knobeast/knobeast/TRADEMARK.md

# Trademark policy / Política de marca

**English**

"knobeast" and the knobeast logo (the italic wordmark with the knob-shaped "O", in `marca/`) are trademarks used by DSM Beauty, S.L. for the knobeast product. They are **not** covered by the open-source licences of this repository (GPL-3.0, CERN-OHL-S-2.0, CC BY-SA 4.0).

You are welcome to:
- build, modify, share and sell devices made from this project, as the licences allow;
- say truthfully that your device is "based on knobeast" or "compatible with knobeast";
- use the name to refer to this project, for example in articles, videos or reviews.

Please don't:
- call your own device, kit, firmware or fork "knobeast";
- use the knobeast logo on it or on its packaging;
- present it as made, sold or endorsed by knobeast.

When you make a fork, give it a different name and remove the logo: `logo_on = false` in `caja/knobeast_caja.scad` and `SPLASH_TITLE` in `pico/config.py`.

Questions: contact@knobeast.com

**Español**

«knobeast» y su logo (el nombre en cursiva con la «O» de pomo, en `marca/`) son marcas que DSM Beauty, S.L. usa para el producto knobeast. **No** están incluidas en las licencias abiertas de este repositorio.

Puedes:
- fabricar, modificar, compartir y vender aparatos basados en el proyecto, según sus licencias;
- decir con verdad que están «basados en knobeast».

No puedes:
- llamar «knobeast» a tu aparato, kit o versión;
- usar el logo;
- dar a entender que lo hace o lo respalda knobeast.

En una versión propia, ponle otro nombre y quita el logo: `logo_on = false` en el `.scad` y `SPLASH_TITLE` en `config.py`.

Dudas: contact@knobeast.com
