knobeast/knobeast/docs/img/render_hero.jpg

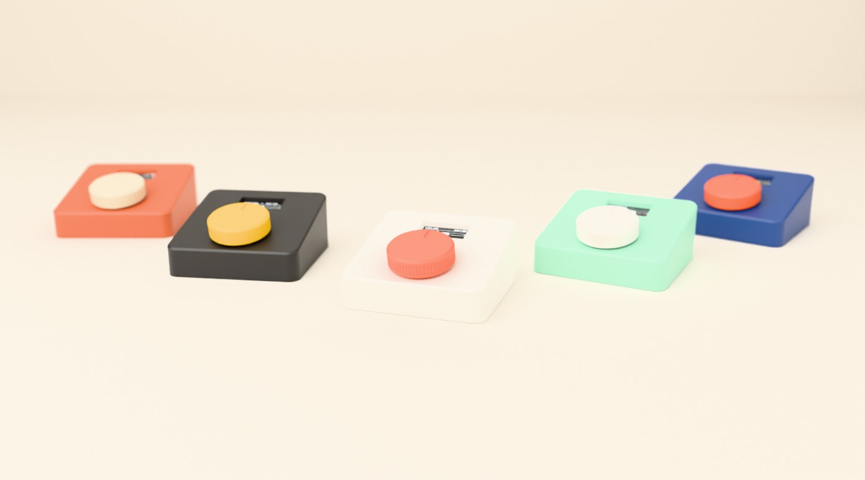
docs/img/render_hero.jpg
