knobeast/knobeast/docs/img/render_pared_lado.jpg

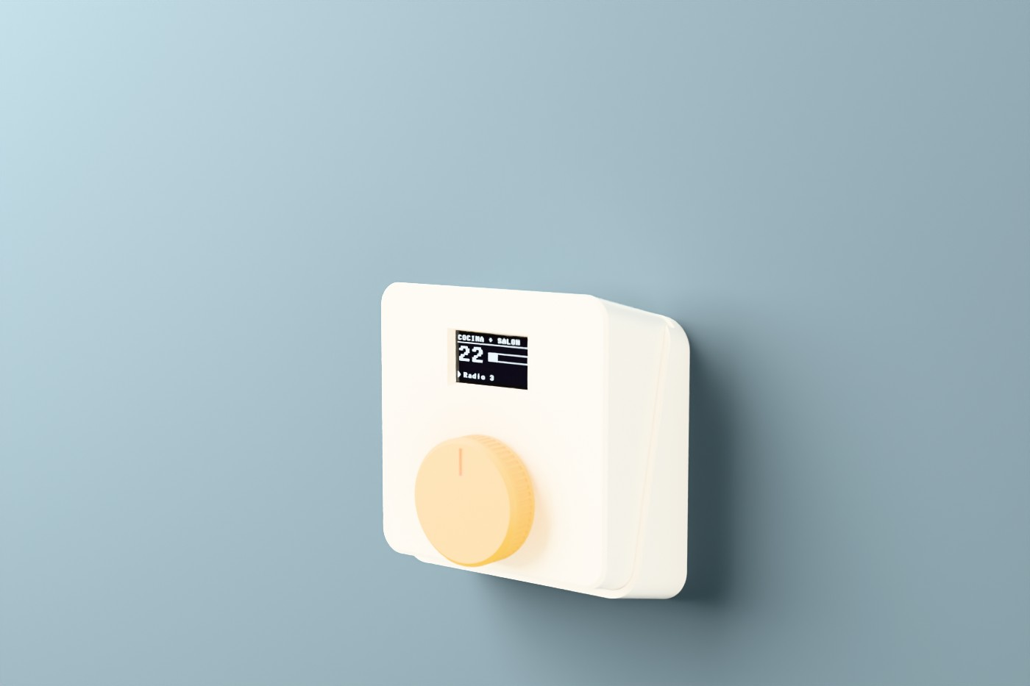
docs/img/render_pared_lado.jpg
