knobeast/knobeast/docs/img/social-preview.jpg

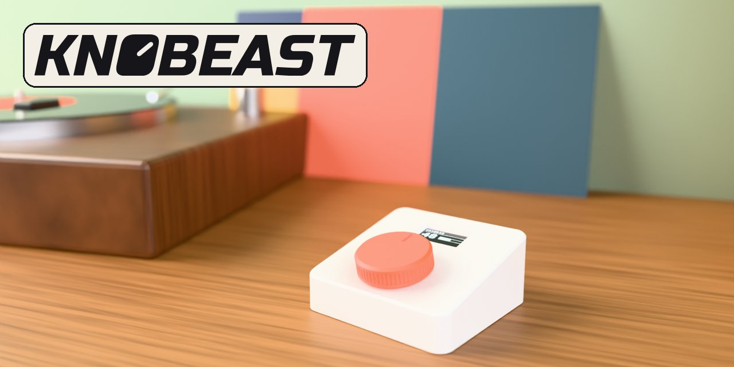
docs/img/social-preview.jpg
