knobeast/knobeast/marca/marca_negro.png

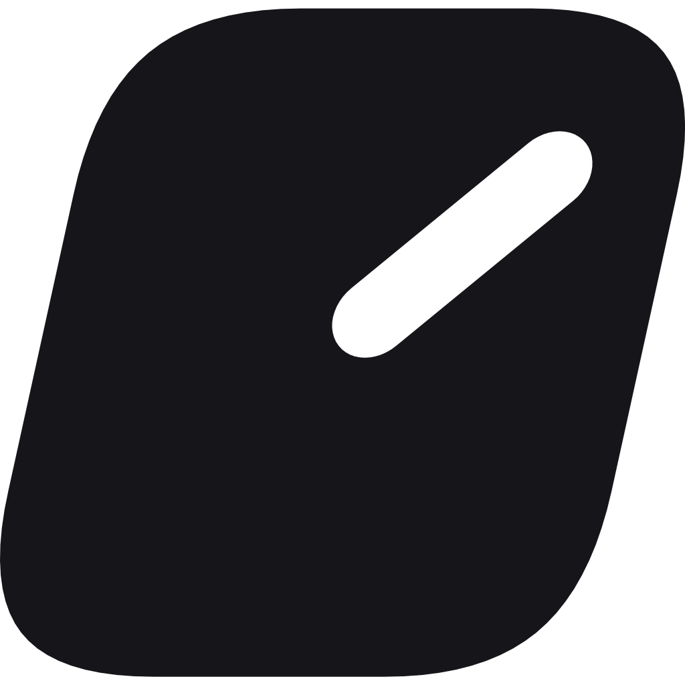
marca/marca_negro.png
