knobeast/knobeast/caja/knobeast_1_carcasa.stl

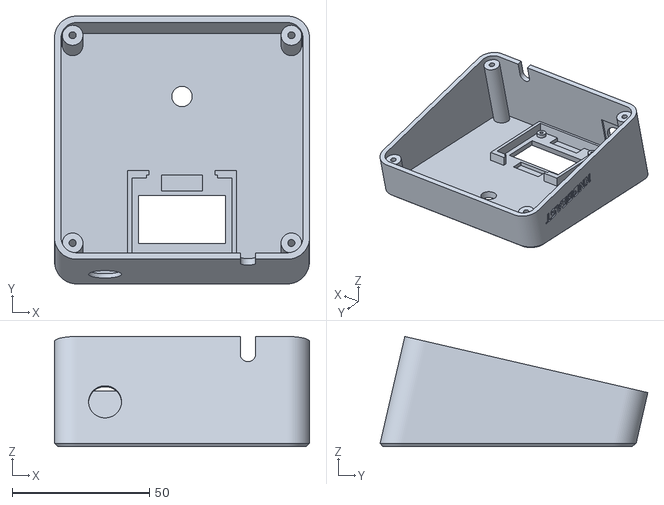
[picture p12: CAD file, 2026-10-18]
caja/knobeast_1_carcasa.stl
92.8 x 97.4 x 40.0
