knobeast/knobeast/caja/knobeast_2_tapa_inferior.stl

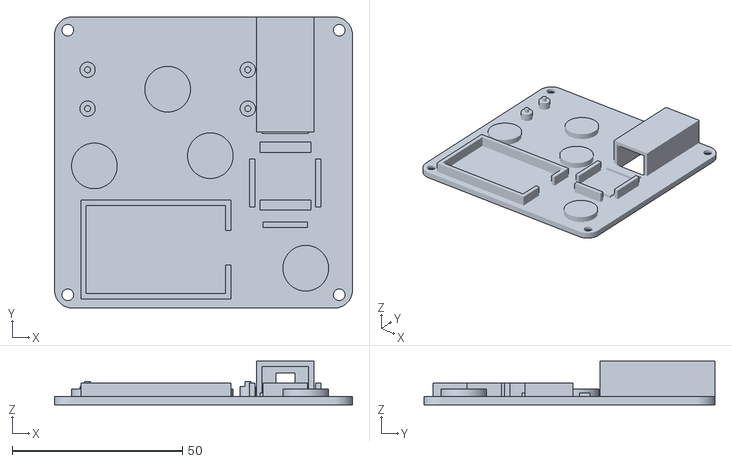
[picture p13: CAD file, 2026-10-17]
caja/knobeast_2_tapa_inferior.stl
87.4 x 85.4 x 12.8
