knobeast/knobeast/caja/knobeast_4_soporte_pared.stl

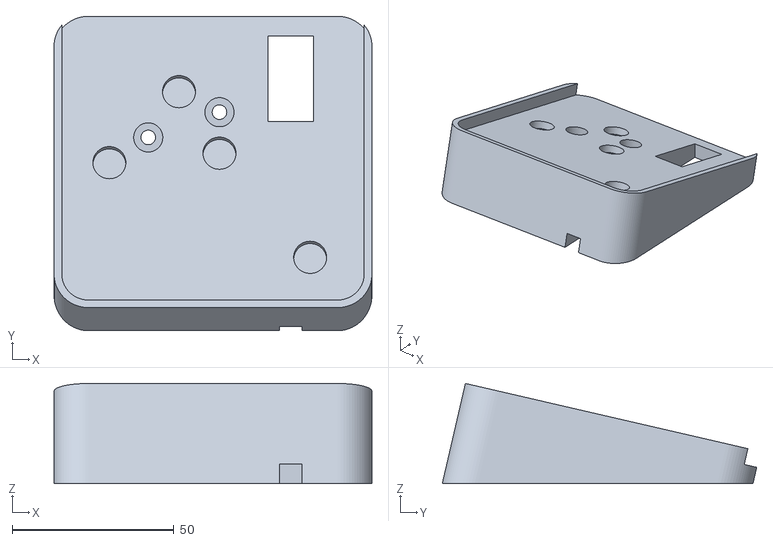
[picture p14: CAD file, 2026-10-17]
caja/knobeast_4_soporte_pared.stl
98.2 x 97.1 x 30.9
