knobeast/knobeast/caja/knobeast_3_pomo.stl

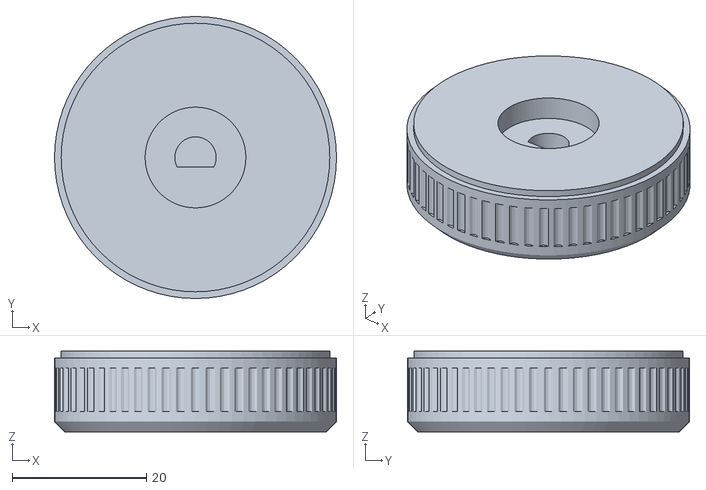
[picture p15: CAD file, 2026-10-17]
caja/knobeast_3_pomo.stl
42.0 x 42.0 x 12.0
