knobeast/knobeast/caja/logo_knobeast.scad

// Logo knobeast (Russo One cursiva, «O» de pomo). Ancho 1 x alto 0.1294: usar scale(ancho).
logo_aspect = 0.12938;
module logo_knobeast_unit() {
    polygon(points=[[0.78898, 0.02613], [0.7959, 0.02583], [0.80219, 0.02559], [0.80786, 0.0254], [0.81291, 0.02527], [0.81733, 0.02518], [0.82113, 0.02516], [0.82195, 0.02518], [0.82274, 0.02525], [0.82351, 0.02538], [0.82425, 0.02555], [0.82497, 0.02576], [0.82567, 0.02603], [0.82634, 0.02635], [0.82699, 0.02671], [0.82762, 0.02712], [0.82822, 0.02758], [0.8288, 0.02809], [0.82933, 0.02862], [0.82982, 0.02919], [0.83026, 0.0298], [0.83067, 0.03044], [0.83104, 0.03111], [0.83136, 0.03182], [0.83165, 0.03256], [0.83189, 0.03333], [0.83209, 0.03414], [0.83565, 0.05031], [0.79432, 0.05031], [0.79067, 0.0504], [0.78726, 0.05066], [0.7841, 0.05108], [0.78118, 0.05168], [0.77851, 0.05245], [0.77608, 0.05339], [0.77389, 0.0545], [0.77195, 0.05578], [0.77025, 0.05723], [0.7688, 0.05885], [0.76757, 0.06066], [0.76657, 0.06268], [0.76577, 0.0649], [0.7652, 0.06733], [0.76484, 0.06997], [0.7647, 0.07281], [0.76477, 0.07586], [0.76506, 0.07912], [0.76557, 0.08258], [0.76629, 0.08625], [0.76748, 0.09164], [0.76837, 0.09531], [0.76939, 0.09878], [0.77053, 0.10204], [0.7718, 0.10509], [0.77319, 0.10793], [0.77471, 0.11057], [0.77636, 0.113], [0.77812, 0.11522], [0.78002, 0.11724], [0.78204, 0.11905], [0.78421, 0.12067], [0.78654, 0.12212], [0.78905, 0.1234], [0.79172, 0.12451], [0.79457, 0.12545], [0.79758, 0.12622], [0.80076, 0.12681], [0.80411, 0.12724], [0.80763, 0.1275], [0.81132, 0.12758], [0.87439, 0.12758], [0.86886, 0.10243], [0.81297, 0.10243], [0.8109, 0.10232], [0.809, 0.10199], [0.80726, 0.10146], [0.80569, 0.1007], [0.80429, 0.09973], [0.80306, 0.09854], [0.802, 0.09714], [0.80111, 0.09553], [0.80038, 0.09369], [0.79982, 0.09164], [0.79903, 0.08805], [0.79869, 0.086], [0.79861, 0.08417], [0.79879, 0.08255], [0.79924, 0.08115], [0.79995, 0.07996], [0.80092, 0.07899], [0.80215, 0.07824], [0.80365, 0.0777], [0.80541, 0.07738], [0.80744, 0.07727], [0.83978, 0.07727], [0.84319, 0.07719], [0.84638, 0.07694], [0.84935, 0.07652], [0.85209, 0.07595], [0.8546, 0.0752], [0.8569, 0.07429], [0.85897, 0.07322], [0.86082, 0.07198], [0.86244, 0.07057], [0.86384, 0.069], [0.86503, 0.06726], [0.86601, 0.06532], [0.86678, 0.0632], [0.86735, 0.06089], [0.86771, 0.0584], [0.86786, 0.05572], [0.86781, 0.05285], [0.86755, 0.0498], [0.86709, 0.04656], [0.86642, 0.04313], [0.86444, 0.03414], [0.8636, 0.03071], [0.86264, 0.02747], [0.86156, 0.02442], [0.86035, 0.02155], [0.85901, 0.01887], [0.85755, 0.01637], [0.85597, 0.01407], [0.85427, 0.01195], [0.85243, 0.01001], [0.85048, 0.00827], [0.84839, 0.0067], [0.84614, 0.00529], [0.84375, 0.00405], [0.84121, 0.00298], [0.83851, 0.00207], [0.83567, 0.00132], [0.83267, 0.00074], [0.82953, 0.00033], [0.82623, 8e-05], [0.82279, 0.0], [0.82094, 0.0], [0.81908, 1e-05], [0.8172, 3e-05], [0.81529, 6e-05], [0.81337, 9e-05], [0.81143, 0.00013], [0.80947, 0.00018], [0.80748, 0.00023], [0.80548, 0.00029], [0.80346, 0.00036], [0.78708, 0.00108], [0.78345, 0.00127], [0.77979, 0.00147], [0.77611, 0.00168], [0.7724, 0.00191], [0.76868, 0.00216], [0.76493, 0.00242], [0.76116, 0.00269], [0.75737, 0.00298], [0.75356, 0.00328], [0.74972, 0.00359], [0.75506, 0.02785], [0.76447, 0.02734], [0.77327, 0.02688], [0.78144, 0.02648]], paths=[[0, 1, 2, 3, 4, 5, 6, 7, 8, 9, 10, 11, 12, 13, 14, 15, 16, 17, 18, 19, 20, 21, 22, 23, 24, 25, 26, 27, 28, 29, 30, 31, 32, 33, 34, 35, 36, 37, 38, 39, 40, 41, 42, 43, 44, 45, 46, 47, 48, 49, 50, 51, 52, 53, 54, 55, 56, 57, 58, 59, 60, 61, 62, 63, 64, 65, 66, 67, 68, 69, 70, 71, 72, 73, 74, 75, 76, 77, 78, 79, 80, 81, 82, 83, 84, 85, 86, 87, 88, 89, 90, 91, 92, 93, 94, 95, 96, 97, 98, 99, 100, 101, 102, 103, 104, 105, 106, 107, 108, 109, 110, 111, 112, 113, 114, 115, 116, 117, 118, 119, 120, 121, 122, 123, 124, 125, 126, 127, 128, 129, 130, 131, 132, 133, 134, 135, 136, 137, 138, 139, 140, 141, 142, 143, 144, 145, 146, 147, 148, 149, 150, 151, 152, 153, 154, 155, 156, 157, 158, 159, 160]]);
    polygon(points=[[0.04915, 0.07817], [0.06532, 0.07817], [0.10422, 0.12758], [0.13836, 0.12758], [0.08951, 0.06559], [0.11051, 0.0018], [0.07637, 0.0018], [0.05978, 0.05301], [0.04361, 0.05301], [0.03235, 0.0018], [0.0, 0.0018], [0.02767, 0.12758], [0.06002, 0.12758]], paths=[[0, 1, 2, 3, 4, 5, 6, 7, 8, 9, 10, 11, 12]]);
    polygon(points=[[0.12147, 0.0018], [0.14915, 0.12758], [0.18329, 0.12758], [0.20981, 0.05211], [0.22642, 0.12758], [0.25876, 0.12758], [0.23109, 0.0018], [0.19695, 0.0018], [0.17042, 0.07727], [0.15382, 0.0018]], paths=[[0, 1, 2, 3, 4, 5, 6, 7, 8, 9]]);
    polygon(points=[[0.36765, 0.01965], [0.36613, 0.01702], [0.36449, 0.01459], [0.36272, 0.01236], [0.36083, 0.01035], [0.35881, 0.00854], [0.35664, 0.00691], [0.3543, 0.00546], [0.3518, 0.00418], [0.34912, 0.00307], [0.34628, 0.00213], [0.34327, 0.00137], [0.34008, 0.00077], [0.33673, 0.00034], [0.33321, 9e-05], [0.32952, 0.0], [0.2846, 0.0], [0.28095, 9e-05], [0.27754, 0.00034], [0.27438, 0.00077], [0.27146, 0.00137], [0.26878, 0.00213], [0.26635, 0.00307], [0.26417, 0.00418], [0.26223, 0.00546], [0.26053, 0.00691], [0.25907, 0.00854], [0.25785, 0.01035], [0.25684, 0.01236], [0.25605, 0.01459], [0.25548, 0.01702], [0.25512, 0.01965], [0.25498, 0.0225], [0.25505, 0.02555], [0.25534, 0.02881], [0.25585, 0.03227], [0.25657, 0.03594], [0.26922, 0.09344], [0.27011, 0.09711], [0.27113, 0.10058], [0.27227, 0.10383], [0.27354, 0.10688], [0.27493, 0.10973], [0.27645, 0.11236], [0.2781, 0.11479], [0.27987, 0.11702], [0.28176, 0.11903], [0.28378, 0.12084], [0.28595, 0.12247], [0.28829, 0.12392], [0.29079, 0.1252], [0.29347, 0.12631], [0.29631, 0.12725], [0.29932, 0.12801], [0.3025, 0.12861], [0.30585, 0.12904], [0.30937, 0.12929], [0.31306, 0.12938], [0.35799, 0.12938], [0.36164, 0.12929], [0.36505, 0.12904], [0.36821, 0.12861], [0.37113, 0.12801], [0.3738, 0.12725], [0.37623, 0.12631], [0.37842, 0.1252], [0.38036, 0.12392], [0.38206, 0.12247], [0.38351, 0.12084], [0.38474, 0.11903], [0.38574, 0.11702], [0.38653, 0.11479], [0.38711, 0.11236], [0.38747, 0.10973], [0.38761, 0.10688], [0.38754, 0.10383], [0.38725, 0.10058], [0.38674, 0.09711], [0.38602, 0.09344], [0.37337, 0.03594], [0.37248, 0.03227], [0.37146, 0.02881], [0.37032, 0.02555], [0.36905, 0.0225], [0.32072, 0.07266], [0.32017, 0.07169], [0.31975, 0.07067], [0.31946, 0.06965], [0.3193, 0.06862], [0.31928, 0.0676], [0.31939, 0.06663], [0.31964, 0.0657], [0.32003, 0.06485], [0.32054, 0.06407], [0.32116, 0.06339], [0.3219, 0.06282], [0.32272, 0.06236], [0.32362, 0.06203], [0.32459, 0.06183], [0.3256, 0.06176], [0.32665, 0.06183], [0.3277, 0.06203], [0.32875, 0.06236], [0.32978, 0.06282], [0.33076, 0.06339], [0.33169, 0.06407], [0.36595, 0.09215], [0.3668, 0.09293], [0.36756, 0.09378], [0.36822, 0.09471], [0.36876, 0.09569], [0.36919, 0.0967], [0.36948, 0.09773], [0.36964, 0.09876], [0.36966, 0.09977], [0.36955, 0.10074], [0.36929, 0.10167], [0.36891, 0.10253], [0.3684, 0.1033], [0.36777, 0.10398], [0.36704, 0.10455], [0.36622, 0.10501], [0.36531, 0.10534], [0.36435, 0.10554], [0.36333, 0.10561], [0.36229, 0.10554], [0.36123, 0.10534], [0.36018, 0.10501], [0.35916, 0.10455], [0.35817, 0.10398], [0.35725, 0.1033], [0.32299, 0.07522], [0.32214, 0.07445], [0.32138, 0.07359]], paths=[[0, 1, 2, 3, 4, 5, 6, 7, 8, 9, 10, 11, 12, 13, 14, 15, 16, 17, 18, 19, 20, 21, 22, 23, 24, 25, 26, 27, 28, 29, 30, 31, 32, 33, 34, 35, 36, 37, 38, 39, 40, 41, 42, 43, 44, 45, 46, 47, 48, 49, 50, 51, 52, 53, 54, 55, 56, 57, 58, 59, 60, 61, 62, 63, 64, 65, 66, 67, 68, 69, 70, 71, 72, 73, 74, 75, 76, 77, 78, 79, 80, 81, 82, 83], [84, 85, 86, 87, 88, 89, 90, 91, 92, 93, 94, 95, 96, 97, 98, 99, 100, 101, 102, 103, 104, 105, 106, 107, 108, 109, 110, 111, 112, 113, 114, 115, 116, 117, 118, 119, 120, 121, 122, 123, 124, 125, 126, 127, 128, 129, 130, 131, 132, 133]]);
    polygon(points=[[0.49821, 0.12558], [0.50051, 0.1247], [0.50259, 0.12366], [0.50445, 0.12247], [0.50608, 0.12111], [0.5075, 0.11959], [0.5087, 0.1179], [0.50969, 0.11605], [0.51049, 0.11404], [0.51108, 0.11185], [0.51148, 0.1095], [0.51167, 0.10698], [0.51165, 0.1043], [0.51144, 0.10144], [0.51102, 0.09842], [0.5104, 0.09524], [0.50989, 0.09312], [0.5093, 0.09109], [0.50864, 0.08913], [0.5079, 0.08726], [0.50709, 0.08547], [0.5062, 0.08376], [0.50523, 0.08212], [0.50419, 0.08058], [0.50307, 0.07911], [0.50188, 0.07772], [0.50063, 0.07641], [0.49937, 0.07518], [0.49807, 0.07404], [0.49675, 0.07297], [0.49541, 0.07199], [0.49404, 0.07109], [0.49264, 0.07027], [0.49122, 0.06952], [0.48977, 0.06886], [0.4883, 0.06828], [0.49092, 0.06738], [0.4933, 0.06624], [0.49544, 0.06488], [0.49735, 0.06328], [0.49902, 0.06146], [0.50045, 0.0594], [0.50164, 0.05711], [0.5026, 0.0546], [0.50332, 0.05185], [0.5038, 0.04888], [0.50389, 0.04774], [0.50394, 0.04658], [0.50394, 0.04537], [0.50391, 0.04413], [0.50382, 0.04286], [0.5037, 0.04155], [0.50352, 0.0402], [0.50331, 0.03881], [0.50305, 0.03739], [0.50275, 0.03594], [0.50191, 0.03251], [0.50095, 0.02927], [0.49987, 0.02621], [0.49866, 0.02335], [0.49732, 0.02066], [0.49586, 0.01817], [0.49428, 0.01586], [0.49258, 0.01374], [0.49075, 0.01181], [0.48879, 0.01006], [0.4867, 0.00849], [0.48446, 0.00709], [0.48206, 0.00585], [0.47952, 0.00477], [0.47682, 0.00386], [0.47398, 0.00312], [0.47098, 0.00254], [0.46784, 0.00213], [0.46454, 0.00188], [0.4611, 0.0018], [0.38383, 0.0018], [0.4115, 0.12758], [0.48338, 0.12758], [0.48679, 0.1275], [0.48998, 0.12726], [0.49294, 0.12686], [0.49569, 0.1263], [0.47067, 0.04942], [0.4697, 0.05039], [0.46847, 0.05114], [0.46697, 0.05168], [0.46521, 0.052], [0.46318, 0.05211], [0.42724, 0.05211], [0.42171, 0.02695], [0.45765, 0.02695], [0.45972, 0.02706], [0.46162, 0.02739], [0.46336, 0.02792], [0.46493, 0.02868], [0.46633, 0.02965], [0.46756, 0.03084], [0.46862, 0.03224], [0.46951, 0.03385], [0.47024, 0.03569], [0.4708, 0.03774], [0.47159, 0.04133], [0.47193, 0.04338], [0.47201, 0.04521], [0.47183, 0.04683], [0.47138, 0.04823], [0.47706, 0.09854], [0.47635, 0.09973], [0.47538, 0.1007], [0.47414, 0.10146], [0.47265, 0.10199], [0.47088, 0.10232], [0.46886, 0.10243], [0.43831, 0.10243], [0.43278, 0.07727], [0.46332, 0.07727], [0.4654, 0.07738], [0.4673, 0.0777], [0.46904, 0.07824], [0.4706, 0.07899], [0.472, 0.07996], [0.47323, 0.08115], [0.4743, 0.08255], [0.47519, 0.08417], [0.47592, 0.086], [0.47648, 0.08805], [0.47727, 0.09164], [0.47761, 0.09369], [0.47769, 0.09553], [0.47751, 0.09714]], paths=[[0, 1, 2, 3, 4, 5, 6, 7, 8, 9, 10, 11, 12, 13, 14, 15, 16, 17, 18, 19, 20, 21, 22, 23, 24, 25, 26, 27, 28, 29, 30, 31, 32, 33, 34, 35, 36, 37, 38, 39, 40, 41, 42, 43, 44, 45, 46, 47, 48, 49, 50, 51, 52, 53, 54, 55, 56, 57, 58, 59, 60, 61, 62, 63, 64, 65, 66, 67, 68, 69, 70, 71, 72, 73, 74, 75, 76, 77, 78, 79, 80, 81, 82], [83, 84, 85, 86, 87, 88, 89, 90, 91, 92, 93, 94, 95, 96, 97, 98, 99, 100, 101, 102, 103, 104, 105, 106], [107, 108, 109, 110, 111, 112, 113, 114, 115, 116, 117, 118, 119, 120, 121, 122, 123, 124, 125, 126, 127, 128, 129, 130]]);
    polygon(points=[[0.63328, 0.10243], [0.56589, 0.10243], [0.56056, 0.07817], [0.61357, 0.07817], [0.60803, 0.05301], [0.55502, 0.05301], [0.54929, 0.02695], [0.61668, 0.02695], [0.61114, 0.0018], [0.51141, 0.0018], [0.53908, 0.12758], [0.63881, 0.12758]], paths=[[0, 1, 2, 3, 4, 5, 6, 7, 8, 9, 10, 11]]);
    polygon(points=[[0.70907, 0.0018], [0.70593, 0.02426], [0.66101, 0.02426], [0.64798, 0.0018], [0.61294, 0.0018], [0.68823, 0.12758], [0.72417, 0.12758], [0.74412, 0.0018], [0.70298, 0.04762], [0.6979, 0.08985], [0.67423, 0.04762]], paths=[[0, 1, 2, 3, 4, 5, 6, 7], [8, 9, 10]]);
    polygon(points=[[0.89218, 0.12758], [1.0, 0.12758], [0.99447, 0.10243], [0.95673, 0.10243], [0.93459, 0.0018], [0.90225, 0.0018], [0.92438, 0.10243], [0.88665, 0.10243]], paths=[[0, 1, 2, 3, 4, 5, 6, 7]]);
}
