knobeast/knobeast/pico/ed25519.py

# ed25519.py — firmas Ed25519 (RFC 8032) en Python puro, para MicroPython y Python normal.
# En el mando solo se usa verify(); sign() lo usa publicar_actualizacion.py en el Mac.
# Verificar tarda unos segundos en la Pico: solo se hace una vez por actualización.
try:
    from hashlib import sha512 as _sha512_lib
except ImportError:
    _sha512_lib = None

# ---------------------------------------------------------------- SHA-512 (la Pico no la trae)
_K = (
    0x428a2f98d728ae22, 0x7137449123ef65cd, 0xb5c0fbcfec4d3b2f, 0xe9b5dba58189dbbc, 0x3956c25bf348b538,
    0x59f111f1b605d019, 0x923f82a4af194f9b, 0xab1c5ed5da6d8118, 0xd807aa98a3030242, 0x12835b0145706fbe,
    0x243185be4ee4b28c, 0x550c7dc3d5ffb4e2, 0x72be5d74f27b896f, 0x80deb1fe3b1696b1, 0x9bdc06a725c71235,
    0xc19bf174cf692694, 0xe49b69c19ef14ad2, 0xefbe4786384f25e3, 0x0fc19dc68b8cd5b5, 0x240ca1cc77ac9c65,
    0x2de92c6f592b0275, 0x4a7484aa6ea6e483, 0x5cb0a9dcbd41fbd4, 0x76f988da831153b5, 0x983e5152ee66dfab,
    0xa831c66d2db43210, 0xb00327c898fb213f, 0xbf597fc7beef0ee4, 0xc6e00bf33da88fc2, 0xd5a79147930aa725,
    0x06ca6351e003826f, 0x142929670a0e6e70, 0x27b70a8546d22ffc, 0x2e1b21385c26c926, 0x4d2c6dfc5ac42aed,
    0x53380d139d95b3df, 0x650a73548baf63de, 0x766a0abb3c77b2a8, 0x81c2c92e47edaee6, 0x92722c851482353b,
    0xa2bfe8a14cf10364, 0xa81a664bbc423001, 0xc24b8b70d0f89791, 0xc76c51a30654be30, 0xd192e819d6ef5218,
    0xd69906245565a910, 0xf40e35855771202a, 0x106aa07032bbd1b8, 0x19a4c116b8d2d0c8, 0x1e376c085141ab53,
    0x2748774cdf8eeb99, 0x34b0bcb5e19b48a8, 0x391c0cb3c5c95a63, 0x4ed8aa4ae3418acb, 0x5b9cca4f7763e373,
    0x682e6ff3d6b2b8a3, 0x748f82ee5defb2fc, 0x78a5636f43172f60, 0x84c87814a1f0ab72, 0x8cc702081a6439ec,
    0x90befffa23631e28, 0xa4506cebde82bde9, 0xbef9a3f7b2c67915, 0xc67178f2e372532b, 0xca273eceea26619c,
    0xd186b8c721c0c207, 0xeada7dd6cde0eb1e, 0xf57d4f7fee6ed178, 0x06f067aa72176fba, 0x0a637dc5a2c898a6,
    0x113f9804bef90dae, 0x1b710b35131c471b, 0x28db77f523047d84, 0x32caab7b40c72493, 0x3c9ebe0a15c9bebc,
    0x431d67c49c100d4c, 0x4cc5d4becb3e42b6, 0x597f299cfc657e2a, 0x5fcb6fab3ad6faec, 0x6c44198c4a475817)
_M = 0xFFFFFFFFFFFFFFFF


def _ror(x, n):
    return ((x >> n) | (x << (64 - n))) & _M


def _sha512_py(data):
    h = [0x6a09e667f3bcc908, 0xbb67ae8584caa73b, 0x3c6ef372fe94f82b, 0xa54ff53a5f1d36f1,
         0x510e527fade682d1, 0x9b05688c2b3e6c1f, 0x1f83d9abfb41bd6b, 0x5be0cd19137e2179]
    ml = len(data)
    data = bytes(data) + b"\x80" + b"\x00" * ((111 - ml) % 128) + (ml * 8).to_bytes(16, "big")
    for off in range(0, len(data), 128):
        w = [int.from_bytes(data[off + 8 * i:off + 8 * i + 8], "big") for i in range(16)]
        for i in range(16, 80):
            s0 = _ror(w[i - 15], 1) ^ _ror(w[i - 15], 8) ^ (w[i - 15] >> 7)
            s1 = _ror(w[i - 2], 19) ^ _ror(w[i - 2], 61) ^ (w[i - 2] >> 6)
            w.append((w[i - 16] + s0 + w[i - 7] + s1) & _M)
        a, b, c, d, e, f, g, hh = h
        for i in range(80):
            t1 = (hh + (_ror(e, 14) ^ _ror(e, 18) ^ _ror(e, 41)) + ((e & f) ^ (~e & g)) + _K[i] + w[i]) & _M
            t2 = ((_ror(a, 28) ^ _ror(a, 34) ^ _ror(a, 39)) + ((a & b) ^ (a & c) ^ (b & c))) & _M
            hh, g, f, e, d, c, b, a = g, f, e, (d + t1) & _M, c, b, a, (t1 + t2) & _M
        h = [(x + y) & _M for x, y in zip(h, (a, b, c, d, e, f, g, hh))]
    return b"".join(x.to_bytes(8, "big") for x in h)


def sha512(data):
    if _sha512_lib:
        return _sha512_lib(data).digest()
    return _sha512_py(data)


# ---------------------------------------------------------------- curva Ed25519
P = 2 ** 255 - 19
L = 2 ** 252 + 27742317777372353535851937790883648493
D = (-121665 * pow(121666, P - 2, P)) % P
SQRT_M1 = pow(2, (P - 1) // 4, P)
_GY = (4 * pow(5, P - 2, P)) % P


def _recover_x(y, sign):
    if y >= P:
        return None
    x2 = (y * y - 1) * pow(D * y * y + 1, P - 2, P) % P
    if x2 == 0:
        return None if sign else 0
    x = pow(x2, (P + 3) // 8, P)
    if (x * x - x2) % P != 0:
        x = x * SQRT_M1 % P
    if (x * x - x2) % P != 0:
        return None
    if (x & 1) != sign:
        x = P - x
    return x


_GX = _recover_x(_GY, 0)
G = (_GX, _GY, 1, _GX * _GY % P)
_ZERO = (0, 1, 1, 0)


def _add(p1, p2):
    x1, y1, z1, t1 = p1
    x2, y2, z2, t2 = p2
    a = (y1 - x1) * (y2 - x2) % P
    b = (y1 + x1) * (y2 + x2) % P
    c = 2 * t1 * t2 * D % P
    d = 2 * z1 * z2 % P
    e, f, g, h = b - a, d - c, d + c, b + a
    return (e * f % P, g * h % P, f * g % P, e * h % P)


def _mul(s, pt):
    q = _ZERO
    while s > 0:
        if s & 1:
            q = _add(q, pt)
        pt = _add(pt, pt)
        s >>= 1
    return q


def _equal(p1, p2):
    x1, y1, z1, _ = p1
    x2, y2, z2, _ = p2
    return (x1 * z2 - x2 * z1) % P == 0 and (y1 * z2 - y2 * z1) % P == 0


def _compress(pt):
    x, y, z, _ = pt
    zi = pow(z, P - 2, P)
    x, y = x * zi % P, y * zi % P
    return (y | ((x & 1) << 255)).to_bytes(32, "little")


def _decompress(s):
    if len(s) != 32:
        return None
    y = int.from_bytes(s, "little")
    sign = y >> 255
    y &= (1 << 255) - 1
    x = _recover_x(y, sign)
    if x is None:
        return None
    return (x, y, 1, x * y % P)


def _h(m):
    return int.from_bytes(sha512(m), "little")


# ---------------------------------------------------------------- API
def verify(public, msg, signature):
    """True si signature (64 bytes) es una firma válida de msg con la clave pública (32 bytes)."""
    if len(public) != 32 or len(signature) != 64:
        return False
    a = _decompress(public)
    r = _decompress(signature[:32])
    if a is None or r is None:
        return False
    s = int.from_bytes(signature[32:], "little")
    if s >= L:
        return False
    h = _h(signature[:32] + public + msg) % L
    return _equal(_mul(s, G), _add(r, _mul(h, a)))


def _expand(secret):
    h = sha512(secret)
    a = int.from_bytes(h[:32], "little")
    a &= (1 << 254) - 8
    a |= 1 << 254
    return a, h[32:]


def public_key(secret):
    a, _ = _expand(secret)
    return _compress(_mul(a, G))


def sign(secret, msg):
    """secret: 32 bytes aleatorios (la clave privada). Devuelve la firma de 64 bytes."""
    a, prefix = _expand(secret)
    pub = _compress(_mul(a, G))
    r = _h(prefix + msg) % L
    rs = _compress(_mul(r, G))
    h = _h(rs + pub + msg) % L
    s = (r + h * a) % L
    return rs + s.to_bytes(32, "little")
