knobeast/knobeast/pico/lang_de.py

# Textos en de. Los de pantalla no deben pasar de 16 letras (sin tildes en la pantalla).
T = {
    'connecting1': 'Verbinde',
    'connecting2': 'mit WLAN...',
    'searching1': 'Suche',
    'noconn1': 'Keine Verbindung',
    'noconn2': 'neuer Versuch...',
    'mute': 'STUMM',
    'vol': 'Vol %d',
    'paused': 'Pausiert',
    'hint_menu': '4s Rad: Menü',
    'hold_rooms': 'Boxen',
    'hold': 'Menü',
    'menu': 'MENÜ',
    'm_rooms': 'Lautsprecher',
    'm_update': 'Update',
    'm_lang': 'Sprache',
    'm_setup': 'Setup (WLAN)',
    'm_system': 'System',
    'sys_title': 'SYSTEM',
    's_auto_on': 'Auto-Update: AN',
    's_auto_off': 'Auto-Update:AUS',
    's_screen': 'Aus nach: %s',
    's_step': 'Vol.-Stufe: %d',
    'norooms1': 'Kein Lautspr.',
    'norooms2': 'Rad druecken',
    's_dim': 'Dimmen: %s',
    'p_screen': 'Display',
    'p_dim': 'Dimmen nach',
    'p_off': 'Ausschalten nach',
    'p_step': 'Lautstärke pro Raste',
    'never': 'nie',
    'splash_boot': 'Startet',
    'splash_wifi': 'WLAN verbinden',
    'splash_sonos': 'Suche Sonos',
    'splash_ok': 'Bereit',
    's_info': 'Info',
    's_reset': 'Zurücksetzen',
    's_back': 'Zurück',
    'reset_title': 'ZURÜCKSETZEN?',
    'reset_yes': 'Ja, löschen',
    'reset_no': 'Nein',
    'reset_done': 'Gelöscht',
    'auto_on': 'Aktiviert',
    'auto_off': 'Deaktiviert',
    'm_reboot': 'Neustart',
    'rooms_title': 'LAUTSPRECHER',
    'save': 'Speichern',
    'cancel': 'Abbrechen',
    'pick_one': 'Mind. einen',
    'saved': 'Gespeichert:',
    'no_wifi': 'Kein WLAN',
    'rooms_search1': 'Suche',
    'rooms_search2': 'Lautsprecher...',
    'none_found1': 'Keine Sonos-',
    'none_found2': 'Lautsprecher',
    'upd_title': 'UPDATE',
    'upd_search': 'Suche...',
    'upd_have': 'Aktuell %s',
    'upd_ok': 'Ist aktuell',
    'upd_ver': 'Version %s',
    'upd_new': 'Neu: %s',
    'upd_dl': 'Lade herunter',
    'upd_dl_n': 'Lade %d/%d',
    'upd_fail': 'Fehler:',
    'upd_done': 'Installiert %s',
    'restarting': 'Neustart...',
    'lang_title': 'SPRACHE',
    'setup_title': 'EINRICHTUNG',
    'setup_join': 'Verbinde mit:',
    'setup_pass': 'Passwort:',
    'setup_qr1': 'Scannen',
    'setup_qr2': 'mit dem',
    'setup_qr3': 'Handy',
    'setup_l1': 'WLAN am Handy:',
    'setup_l3': 'und aufrufen:',
    'st_scanning': 'Suche WLANs',
    'st_waiting': 'Warte auf Handy',
    'st_phone': 'Handy verbunden',
    'st_saved': 'Gespeichert!',
    'st_cancel': 'Abgebrochen',
    'st_recv': 'Empfange...',
    'st_updated': 'Aktualisiert!',
    'p_sub': 'Einrichtung des Lautstärkereglers',
    'p_wifi': 'WLAN zu Hause',
    'p_or': '…oder Namen eingeben',
    'p_or_small': '(falls oben nicht aufgeführt)',
    'p_pass': 'Passwort',
    'p_keep': 'Leer lassen, um das aktuelle zu behalten.',
    'p_maxvol': 'Maximale Lautstärke',
    'p_lang': 'Sprache',
    'p_save': 'Speichern und neu starten',
    'p_rooms': 'Gesteuerte Lautsprecher: %s.',
    'p_rooms_how': 'Änderbar am Regler: Rad 2 s gedrückt halten und loslassen → %s.',
    'p_upd_title': 'Software aktualisieren',
    'p_upd_ver': 'Installierte Version:',
    'p_upd_rolled': 'Das letzte Update funktionierte nicht; der Regler ist von selbst zur vorherigen Version zurückgekehrt.',
    'p_upd_pending': 'Update gerade installiert: wird bestätigt, sobald Sonos verbunden ist.',
    'p_upd_files': 'Neue .py-Dateien',
    'p_upd_files_small': '(mehrere möglich)',
    'p_upd_btn': 'Hochladen und installieren',
    'p_upd_note': 'Startet die neue Version nicht, kehrt er von selbst zur vorherigen zurück. Hängt er, den Regler 3-mal aus- und einschalten.',
    'p_done_title': 'Gespeichert ✓',
    'p_done': 'Der Regler startet neu und verbindet sich mit „%s“. Du kannst wieder ins WLAN zu Hause wechseln.',
    'p_back': 'Zurück',
    'p_err': 'Fehler',
    'p_nofile': 'Keine Datei empfangen.',
    'p_nothing_t': 'Nichts zu installieren',
    'p_nothing': 'Wähle eine oder mehrere .py-Dateien der Software.',
    'p_ignored': 'Ignoriert: %s.',
    'p_notinst_t': 'Nicht installiert',
    'p_unchanged': 'Die Software bleibt unverändert.',
    'p_installed': 'Installiert: %s.',
    'p_inst_note': 'Der Regler startet mit der neuen Version. Erreicht er Sonos nicht, kehrt er von selbst zur vorherigen zurück. Du kannst wieder ins WLAN zu Hause wechseln.',
    'p_updated_t': 'Aktualisiert ✓',
}
