knobeast/knobeast/pico/lang_en.py

# Textos en en. Los de pantalla no deben pasar de 16 letras (sin tildes en la pantalla).
T = {
    'connecting1': 'Connecting',
    'connecting2': 'to wifi...',
    'searching1': 'Finding',
    'noconn1': 'No connection',
    'noconn2': 'retrying...',
    'mute': 'MUTE',
    'vol': 'vol %d',
    'paused': 'Paused',
    'hint_menu': 'Hold 4s: menu',
    'hold_rooms': 'Speakers',
    'hold': 'Menu',
    'menu': 'MENU',
    'm_rooms': 'Speakers',
    'm_update': 'Update',
    'm_lang': 'Language',
    'm_setup': 'Setup (wifi)',
    'm_system': 'System',
    'sys_title': 'SYSTEM',
    's_auto_on': 'Auto-update: ON',
    's_auto_off': 'Auto-update:OFF',
    's_screen': 'Sleep: %s',
    's_step': 'Vol. step: %d',
    'norooms1': 'No speakers',
    'norooms2': 'Press the knob',
    's_dim': 'Dim: %s',
    'p_screen': 'Screen',
    'p_dim': 'Dim after',
    'p_off': 'Turn off after',
    'p_step': 'Volume per wheel click',
    'never': 'never',
    'splash_boot': 'Starting',
    'splash_wifi': 'Joining wifi',
    'splash_sonos': 'Finding Sonos',
    'splash_ok': 'Ready',
    's_info': 'Info',
    's_reset': 'Factory reset',
    's_back': 'Back',
    'reset_title': 'FACTORY RESET?',
    'reset_yes': 'Yes, erase all',
    'reset_no': 'No',
    'reset_done': 'Erased',
    'auto_on': 'Enabled',
    'auto_off': 'Disabled',
    'm_reboot': 'Restart',
    'rooms_title': 'SPEAKERS',
    'save': 'Save',
    'cancel': 'Cancel',
    'pick_one': 'Pick at least 1',
    'saved': 'Saved:',
    'no_wifi': 'No wifi',
    'rooms_search1': 'Looking for',
    'rooms_search2': 'speakers...',
    'none_found1': 'No Sonos',
    'none_found2': 'speakers found',
    'upd_title': 'UPDATE',
    'upd_search': 'Checking...',
    'upd_have': 'You have %s',
    'upd_ok': 'Up to date',
    'upd_ver': 'Version %s',
    'upd_new': 'New: %s',
    'upd_dl': 'Downloading...',
    'upd_dl_n': 'Download %d/%d',
    'upd_fail': 'Failed:',
    'upd_done': 'Installed %s',
    'restarting': 'Restarting...',
    'lang_title': 'LANGUAGE',
    'setup_title': 'SETUP',
    'setup_join': 'Join wifi:',
    'setup_pass': 'Password:',
    'setup_qr1': 'Scan',
    'setup_qr2': 'with',
    'setup_qr3': 'phone',
    'setup_l1': 'Phone wifi:',
    'setup_l3': 'then open:',
    'st_scanning': 'Scanning wifi',
    'st_waiting': 'Waiting phone',
    'st_phone': 'Phone connected',
    'st_saved': 'Saved!',
    'st_cancel': 'Cancelled',
    'st_recv': 'Receiving...',
    'st_updated': 'Updated!',
    'p_sub': 'Volume knob setup',
    'p_wifi': 'Home wifi network',
    'p_or': '…or type its name',
    'p_or_small': "(if it isn't listed above)",
    'p_pass': 'Password',
    'p_keep': 'Leave it empty to keep the current one.',
    'p_maxvol': 'Maximum volume',
    'p_lang': 'Language',
    'p_save': 'Save and restart',
    'p_rooms': 'Speakers it controls: %s.',
    'p_rooms_how': 'Change them on the knob: hold the wheel 2 s and let go → %s.',
    'p_upd_title': 'Update the software',
    'p_upd_ver': 'Installed version:',
    'p_upd_rolled': "The last update didn't work, so the knob went back to the previous version by itself.",
    'p_upd_pending': 'Update just installed: it will be confirmed once it connects to Sonos.',
    'p_upd_files': 'New .py files',
    'p_upd_files_small': '(you can pick several)',
    'p_upd_btn': 'Upload and install',
    'p_upd_note': "If the new version doesn't start, it goes back to the previous one by itself. If it hangs, switch the knob off and on 3 times.",
    'p_done_title': 'Saved ✓',
    'p_done': 'The knob restarts and connects to “%s”. You can switch back to your home wifi now.',
    'p_back': 'Back',
    'p_err': 'Error',
    'p_nofile': 'No file was received.',
    'p_nothing_t': 'Nothing to install',
    'p_nothing': 'Choose one or more .py files of the software.',
    'p_ignored': 'Ignored: %s.',
    'p_notinst_t': 'Not installed',
    'p_unchanged': 'The software is unchanged.',
    'p_installed': 'Installed: %s.',
    'p_inst_note': "The knob restarts with the new version. If it can't reach Sonos, it goes back to the previous one by itself. You can switch back to your home wifi now.",
    'p_updated_t': 'Updated ✓',
}
