knobeast/knobeast/pico/lang_es.py

# Textos en es. Los de pantalla no deben pasar de 16 letras (sin tildes en la pantalla).
T = {
    'connecting1': 'Conectando',
    'connecting2': 'wifi...',
    'searching1': 'Buscando',
    'noconn1': 'Sin conexion',
    'noconn2': 'reintentando...',
    'mute': 'MUTE',
    'vol': 'vol %d',
    'paused': 'En pausa',
    'hint_menu': '4s rueda: menu',
    'hold_rooms': 'Altavoces',
    'hold': 'Menu',
    'menu': 'MENU',
    'm_rooms': 'Altavoces',
    'm_update': 'Actualizar',
    'm_lang': 'Idioma',
    'm_setup': 'Ajustes (wifi)',
    'm_system': 'Sistema',
    'sys_title': 'SISTEMA',
    's_auto_on': 'Act. auto: SI',
    's_auto_off': 'Act. auto: NO',
    's_screen': 'Apagar: %s',
    's_step': 'Paso vol.: %d',
    'norooms1': 'Sin altavoces',
    'norooms2': 'Pulsa la rueda',
    's_dim': 'Atenuar: %s',
    'p_screen': 'Pantalla',
    'p_dim': 'Atenuar tras',
    'p_off': 'Apagar tras',
    'p_step': 'Volumen por cada clic de la rueda',
    'never': 'nunca',
    'splash_boot': 'Arrancando',
    'splash_wifi': 'Conectando wifi',
    'splash_sonos': 'Buscando Sonos',
    'splash_ok': 'Listo',
    's_info': 'Información',
    's_reset': 'Restablecer',
    's_back': 'Volver',
    'reset_title': 'RESTABLECER?',
    'reset_yes': 'Si, borrar todo',
    'reset_no': 'No',
    'reset_done': 'Borrado',
    'auto_on': 'Activada',
    'auto_off': 'Desactivada',
    'm_reboot': 'Reiniciar',
    'rooms_title': 'ALTAVOCES',
    'save': 'Guardar',
    'cancel': 'Cancelar',
    'pick_one': 'Marca alguno',
    'saved': 'Guardado:',
    'no_wifi': 'Sin wifi',
    'rooms_search1': 'Buscando',
    'rooms_search2': 'altavoces...',
    'none_found1': 'No encuentro',
    'none_found2': 'ningun Sonos',
    'upd_title': 'ACTUALIZAR',
    'upd_search': 'Buscando...',
    'upd_have': 'Tienes %s',
    'upd_ok': 'Ya esta al dia',
    'upd_ver': 'Version %s',
    'upd_new': 'Nueva: %s',
    'upd_dl': 'Descargando...',
    'upd_dl_n': 'Descarga %d/%d',
    'upd_fail': 'No se pudo:',
    'upd_done': 'Instalada %s',
    'restarting': 'Reiniciando...',
    'lang_title': 'IDIOMA',
    'setup_title': 'CONFIGURACION',
    'setup_join': 'Conecta a:',
    'setup_pass': 'Clave:',
    'setup_qr1': 'Escanea',
    'setup_qr2': 'con el',
    'setup_qr3': 'movil',
    'setup_l1': 'Wifi del movil:',
    'setup_l3': 'y abre:',
    'st_scanning': 'Buscando redes',
    'st_waiting': 'Esperando movil',
    'st_phone': 'Movil conectado',
    'st_saved': 'Guardado!',
    'st_cancel': 'Cancelado',
    'st_recv': 'Recibiendo...',
    'st_updated': 'Actualizado!',
    'p_sub': 'Configuración del mando de volumen',
    'p_wifi': 'Red wifi de casa',
    'p_or': '…o escribe el nombre',
    'p_or_small': '(si no aparece arriba)',
    'p_pass': 'Contraseña',
    'p_keep': 'Déjala vacía para mantener la actual.',
    'p_maxvol': 'Volumen máximo',
    'p_lang': 'Idioma',
    'p_save': 'Guardar y reiniciar',
    'p_rooms': 'Altavoces que controla: %s.',
    'p_rooms_how': 'Se cambian en el mando: rueda pulsada 2 s y suelta → %s.',
    'p_upd_title': 'Actualizar el programa',
    'p_upd_ver': 'Versión instalada:',
    'p_upd_rolled': 'La última actualización no funcionaba y el mando volvió solo a la versión anterior.',
    'p_upd_pending': 'Actualización recién instalada: se confirmará cuando conecte con Sonos.',
    'p_upd_files': 'Archivos .py nuevos',
    'p_upd_files_small': '(puedes elegir varios)',
    'p_upd_btn': 'Subir e instalar',
    'p_upd_note': 'Si la versión nueva no arranca, vuelve sola a la anterior. Si se queda colgada, apaga y enciende el mando 3 veces.',
    'p_done_title': 'Guardado ✓',
    'p_done': 'El mando se reinicia y se conecta a «%s». Ya puedes volver a la wifi de casa.',
    'p_back': 'Volver',
    'p_err': 'Error',
    'p_nofile': 'No se ha recibido ningún archivo.',
    'p_nothing_t': 'Nada que instalar',
    'p_nothing': 'Elige uno o varios archivos .py del programa.',
    'p_ignored': 'Ignorados: %s.',
    'p_notinst_t': 'No se ha instalado',
    'p_unchanged': 'El programa sigue como estaba.',
    'p_installed': 'Instalados: %s.',
    'p_inst_note': 'El mando se reinicia con la versión nueva. Si no llega a conectar con Sonos, vuelve sola a la anterior. Ya puedes volver a la wifi de casa.',
    'p_updated_t': 'Actualizado ✓',
}
