knobeast/knobeast/pico/lang_fr.py

# Textos en fr. Los de pantalla no deben pasar de 16 letras (sin tildes en la pantalla).
T = {
    'connecting1': 'Connexion',
    'connecting2': 'au wifi...',
    'searching1': 'Cherche',
    'noconn1': 'Pas de connexion',
    'noconn2': 'nouvel essai...',
    'mute': 'MUET',
    'vol': 'vol %d',
    'paused': 'En pause',
    'hint_menu': '4s molette: menu',
    'hold_rooms': 'Enceintes',
    'hold': 'Menu',
    'menu': 'MENU',
    'm_rooms': 'Enceintes',
    'm_update': 'Mise à jour',
    'm_lang': 'Langue',
    'm_setup': 'Réglages (wifi)',
    'm_system': 'Système',
    'sys_title': 'SYSTÈME',
    's_auto_on': 'MAJ auto : OUI',
    's_auto_off': 'MAJ auto : NON',
    's_screen': 'Veille : %s',
    's_step': 'Pas vol.: %d',
    'norooms1': 'Aucune enceinte',
    'norooms2': 'Appuyez molette',
    's_dim': 'Baisser: %s',
    'p_screen': 'Écran',
    'p_dim': 'Baisser après',
    'p_off': 'Éteindre après',
    'p_step': 'Volume par cran de molette',
    'never': 'jamais',
    'splash_boot': 'Démarrage',
    'splash_wifi': 'Connexion wifi',
    'splash_sonos': 'Cherche Sonos',
    'splash_ok': 'Prêt',
    's_info': 'Infos',
    's_reset': 'Réinitialiser',
    's_back': 'Retour',
    'reset_title': 'RÉINITIALISER ?',
    'reset_yes': 'Oui, effacer',
    'reset_no': 'Non',
    'reset_done': 'Effacé',
    'auto_on': 'Activée',
    'auto_off': 'Désactivée',
    'm_reboot': 'Redémarrer',
    'rooms_title': 'ENCEINTES',
    'save': 'Enregistrer',
    'cancel': 'Annuler',
    'pick_one': 'Cochez-en une',
    'saved': 'Enregistré :',
    'no_wifi': 'Pas de wifi',
    'rooms_search1': 'Recherche',
    'rooms_search2': 'des enceintes...',
    'none_found1': 'Aucune enceinte',
    'none_found2': 'Sonos trouvée',
    'upd_title': 'MISE À JOUR',
    'upd_search': 'Recherche...',
    'upd_have': 'Actuelle %s',
    'upd_ok': 'Déjà à jour',
    'upd_ver': 'Version %s',
    'upd_new': 'Nouvelle %s',
    'upd_dl': 'Téléchargement',
    'upd_dl_n': 'Télécharge %d/%d',
    'upd_fail': 'Échec :',
    'upd_done': 'Installée %s',
    'restarting': 'Redémarrage...',
    'lang_title': 'LANGUE',
    'setup_title': 'CONFIGURATION',
    'setup_join': 'Connectez-vous :',
    'setup_pass': 'Mot de passe :',
    'setup_qr1': 'Scannez',
    'setup_qr2': 'avec le',
    'setup_qr3': 'tél.',
    'setup_l1': 'Wifi du tél. :',
    'setup_l3': 'puis ouvrez :',
    'st_scanning': 'Recherche wifi',
    'st_waiting': 'Attente du tél.',
    'st_phone': 'Tél. connecté',
    'st_saved': 'Enregistré !',
    'st_cancel': 'Annulé',
    'st_recv': 'Réception...',
    'st_updated': 'Mis à jour !',
    'p_sub': 'Configuration du bouton de volume',
    'p_wifi': 'Réseau wifi de la maison',
    'p_or': '…ou tapez son nom',
    'p_or_small': "(s'il n'apparaît pas ci-dessus)",
    'p_pass': 'Mot de passe',
    'p_keep': "Laissez vide pour garder l'actuel.",
    'p_maxvol': 'Volume maximum',
    'p_lang': 'Langue',
    'p_save': 'Enregistrer et redémarrer',
    'p_rooms': 'Enceintes contrôlées : %s.',
    'p_rooms_how': 'Changez-les sur le bouton : molette enfoncée 2 s puis relâchée → %s.',
    'p_upd_title': 'Mettre à jour le logiciel',
    'p_upd_ver': 'Version installée :',
    'p_upd_rolled': 'La dernière mise à jour ne fonctionnait pas : le bouton est revenu seul à la version précédente.',
    'p_upd_pending': 'Mise à jour installée : elle sera confirmée dès la connexion à Sonos.',
    'p_upd_files': 'Nouveaux fichiers .py',
    'p_upd_files_small': '(plusieurs possibles)',
    'p_upd_btn': 'Envoyer et installer',
    'p_upd_note': "Si la nouvelle version ne démarre pas, il revient seul à la précédente. S'il se bloque, éteignez et rallumez le bouton 3 fois.",
    'p_done_title': 'Enregistré ✓',
    'p_done': 'Le bouton redémarre et se connecte à « %s ». Vous pouvez revenir au wifi de la maison.',
    'p_back': 'Retour',
    'p_err': 'Erreur',
    'p_nofile': 'Aucun fichier reçu.',
    'p_nothing_t': 'Rien à installer',
    'p_nothing': 'Choisissez un ou plusieurs fichiers .py du logiciel.',
    'p_ignored': 'Ignorés : %s.',
    'p_notinst_t': 'Non installé',
    'p_unchanged': 'Le logiciel est inchangé.',
    'p_installed': 'Installés : %s.',
    'p_inst_note': "Le bouton redémarre avec la nouvelle version. S'il n'arrive pas à joindre Sonos, il revient seul à la précédente. Vous pouvez revenir au wifi de la maison.",
    'p_updated_t': 'Mis à jour ✓',
}
