knobeast/knobeast/pico/lang_it.py

# Textos en it. Los de pantalla no deben pasar de 16 letras (sin tildes en la pantalla).
T = {
    'connecting1': 'Connetto',
    'connecting2': 'al wifi...',
    'searching1': 'Cerco',
    'noconn1': 'Non connesso',
    'noconn2': 'riprovo...',
    'mute': 'MUTO',
    'vol': 'vol %d',
    'paused': 'In pausa',
    'hint_menu': '4s rotella: menu',
    'hold_rooms': 'Casse',
    'hold': 'Menu',
    'menu': 'MENU',
    'm_rooms': 'Altoparlanti',
    'm_update': 'Aggiorna',
    'm_lang': 'Lingua',
    'm_setup': 'Impost. (wifi)',
    'm_system': 'Sistema',
    'sys_title': 'SISTEMA',
    's_auto_on': 'Agg. auto: SI',
    's_auto_off': 'Agg. auto: NO',
    's_screen': 'Spegni: %s',
    's_step': 'Passo vol.: %d',
    'norooms1': 'Nessun altop.',
    'norooms2': 'Premi rotella',
    's_dim': 'Attenua: %s',
    'p_screen': 'Schermo',
    'p_dim': 'Attenua dopo',
    'p_off': 'Spegni dopo',
    'p_step': 'Volume per scatto della rotella',
    'never': 'mai',
    'splash_boot': 'Avvio',
    'splash_wifi': 'Connetto wifi',
    'splash_sonos': 'Cerco Sonos',
    'splash_ok': 'Pronto',
    's_info': 'Info',
    's_reset': 'Ripristina',
    's_back': 'Indietro',
    'reset_title': 'RIPRISTINARE?',
    'reset_yes': 'Sì, cancella',
    'reset_no': 'No',
    'reset_done': 'Cancellato',
    'auto_on': 'Attivato',
    'auto_off': 'Disattivato',
    'm_reboot': 'Riavvia',
    'rooms_title': 'ALTOPARLANTI',
    'save': 'Salva',
    'cancel': 'Annulla',
    'pick_one': 'Scegline uno',
    'saved': 'Salvato:',
    'no_wifi': 'Niente wifi',
    'rooms_search1': 'Cerco',
    'rooms_search2': 'altoparlanti...',
    'none_found1': 'Nessun Sonos',
    'none_found2': 'trovato',
    'upd_title': 'AGGIORNA',
    'upd_search': 'Cerco...',
    'upd_have': 'Hai la %s',
    'upd_ok': 'Già aggiornato',
    'upd_ver': 'Versione %s',
    'upd_new': 'Nuova: %s',
    'upd_dl': 'Scarico...',
    'upd_dl_n': 'Scarico %d/%d',
    'upd_fail': 'Errore:',
    'upd_done': 'Installata %s',
    'restarting': 'Riavvio...',
    'lang_title': 'LINGUA',
    'setup_title': 'CONFIGURAZIONE',
    'setup_join': 'Collegati a:',
    'setup_pass': 'Password:',
    'setup_qr1': 'Leggi',
    'setup_qr2': 'il QR',
    'setup_qr3': 'col tel',
    'setup_l1': 'Wifi del tel.:',
    'setup_l3': 'poi apri:',
    'st_scanning': 'Cerco reti',
    'st_waiting': 'Attendo il tel.',
    'st_phone': 'Tel. connesso',
    'st_saved': 'Salvato!',
    'st_cancel': 'Annullato',
    'st_recv': 'Ricevo...',
    'st_updated': 'Aggiornato!',
    'p_sub': 'Configurazione della manopola del volume',
    'p_wifi': 'Rete wifi di casa',
    'p_or': '…o scrivi il nome',
    'p_or_small': '(se non compare sopra)',
    'p_pass': 'Password',
    'p_keep': 'Lasciala vuota per mantenere quella attuale.',
    'p_maxvol': 'Volume massimo',
    'p_lang': 'Lingua',
    'p_save': 'Salva e riavvia',
    'p_rooms': 'Altoparlanti controllati: %s.',
    'p_rooms_how': 'Si cambiano sulla manopola: rotella premuta 2 s e rilasciata → %s.',
    'p_upd_title': 'Aggiorna il programma',
    'p_upd_ver': 'Versione installata:',
    'p_upd_rolled': "L'ultimo aggiornamento non funzionava e la manopola è tornata da sola alla versione precedente.",
    'p_upd_pending': 'Aggiornamento appena installato: sarà confermato quando si collega a Sonos.',
    'p_upd_files': 'Nuovi file .py',
    'p_upd_files_small': '(puoi sceglierne più di uno)',
    'p_upd_btn': 'Carica e installa',
    'p_upd_note': 'Se la nuova versione non parte, torna da sola alla precedente. Se si blocca, spegni e accendi la manopola 3 volte.',
    'p_done_title': 'Salvato ✓',
    'p_done': 'La manopola si riavvia e si collega a «%s». Puoi tornare al wifi di casa.',
    'p_back': 'Indietro',
    'p_err': 'Errore',
    'p_nofile': 'Nessun file ricevuto.',
    'p_nothing_t': 'Niente da installare',
    'p_nothing': 'Scegli uno o più file .py del programma.',
    'p_ignored': 'Ignorati: %s.',
    'p_notinst_t': 'Non installato',
    'p_unchanged': "Il programma è rimasto com'era.",
    'p_installed': 'Installati: %s.',
    'p_inst_note': 'La manopola si riavvia con la nuova versione. Se non riesce a collegarsi a Sonos, torna da sola alla precedente. Puoi tornare al wifi di casa.',
    'p_updated_t': 'Aggiornato ✓',
}
