knobeast/knobeast/pico/lang_pt.py

# Textos en pt. Los de pantalla no deben pasar de 16 letras (sin tildes en la pantalla).
T = {
    'connecting1': 'A ligar',
    'connecting2': 'ao wifi...',
    'searching1': 'A procurar',
    'noconn1': 'Sem ligação',
    'noconn2': 'a tentar...',
    'mute': 'MUDO',
    'vol': 'vol %d',
    'paused': 'Em pausa',
    'hint_menu': '4s roda: menu',
    'hold_rooms': 'Colunas',
    'hold': 'Menu',
    'menu': 'MENU',
    'm_rooms': 'Colunas',
    'm_update': 'Atualizar',
    'm_lang': 'Idioma',
    'm_setup': 'Ajustes (wifi)',
    'm_system': 'Sistema',
    'sys_title': 'SISTEMA',
    's_auto_on': 'At. auto: SIM',
    's_auto_off': 'At. auto: NÃO',
    's_screen': 'Desligar: %s',
    's_step': 'Passo vol.: %d',
    'norooms1': 'Sem colunas',
    'norooms2': 'Prime a roda',
    's_dim': 'Atenuar: %s',
    'p_screen': 'Ecrã',
    'p_dim': 'Atenuar após',
    'p_off': 'Desligar após',
    'p_step': 'Volume por clique da roda',
    'never': 'nunca',
    'splash_boot': 'A arrancar',
    'splash_wifi': 'A ligar wifi',
    'splash_sonos': 'A procurar Sonos',
    'splash_ok': 'Pronto',
    's_info': 'Informação',
    's_reset': 'Repor fábrica',
    's_back': 'Voltar',
    'reset_title': 'REPOR?',
    'reset_yes': 'Sim, apagar',
    'reset_no': 'Não',
    'reset_done': 'Apagado',
    'auto_on': 'Ativada',
    'auto_off': 'Desativada',
    'm_reboot': 'Reiniciar',
    'rooms_title': 'COLUNAS',
    'save': 'Guardar',
    'cancel': 'Cancelar',
    'pick_one': 'Escolhe uma',
    'saved': 'Guardado:',
    'no_wifi': 'Sem wifi',
    'rooms_search1': 'A procurar',
    'rooms_search2': 'colunas...',
    'none_found1': 'Nenhuma coluna',
    'none_found2': 'Sonos encontrada',
    'upd_title': 'ATUALIZAR',
    'upd_search': 'A procurar...',
    'upd_have': 'Tens a %s',
    'upd_ok': 'Já atualizado',
    'upd_ver': 'Versão %s',
    'upd_new': 'Nova: %s',
    'upd_dl': 'A transferir...',
    'upd_dl_n': 'A baixar %d/%d',
    'upd_fail': 'Erro:',
    'upd_done': 'Instalada %s',
    'restarting': 'A reiniciar...',
    'lang_title': 'IDIOMA',
    'setup_title': 'CONFIGURAÇÃO',
    'setup_join': 'Liga-te a:',
    'setup_pass': 'Palavra-passe:',
    'setup_qr1': 'Lê o QR',
    'setup_qr2': 'com o',
    'setup_qr3': 'tlm.',
    'setup_l1': 'Wifi do tlm.:',
    'setup_l3': 'e abre:',
    'st_scanning': 'A procurar redes',
    'st_waiting': 'À espera do tlm',
    'st_phone': 'Tlm. ligado',
    'st_saved': 'Guardado!',
    'st_cancel': 'Cancelado',
    'st_recv': 'A receber...',
    'st_updated': 'Atualizado!',
    'p_sub': 'Configuração do botão de volume',
    'p_wifi': 'Rede wifi de casa',
    'p_or': '…ou escreve o nome',
    'p_or_small': '(se não aparecer acima)',
    'p_pass': 'Palavra-passe',
    'p_keep': 'Deixa vazia para manter a atual.',
    'p_maxvol': 'Volume máximo',
    'p_lang': 'Idioma',
    'p_save': 'Guardar e reiniciar',
    'p_rooms': 'Colunas que controla: %s.',
    'p_rooms_how': 'Mudam-se no botão: roda premida 2 s e solta → %s.',
    'p_upd_title': 'Atualizar o programa',
    'p_upd_ver': 'Versão instalada:',
    'p_upd_rolled': 'A última atualização não funcionava e o botão voltou sozinho à versão anterior.',
    'p_upd_pending': 'Atualização acabada de instalar: será confirmada quando ligar ao Sonos.',
    'p_upd_files': 'Novos ficheiros .py',
    'p_upd_files_small': '(podes escolher vários)',
    'p_upd_btn': 'Enviar e instalar',
    'p_upd_note': 'Se a nova versão não arrancar, volta sozinha à anterior. Se bloquear, desliga e liga o botão 3 vezes.',
    'p_done_title': 'Guardado ✓',
    'p_done': 'O botão reinicia e liga-se a «%s». Já podes voltar ao wifi de casa.',
    'p_back': 'Voltar',
    'p_err': 'Erro',
    'p_nofile': 'Não foi recebido nenhum ficheiro.',
    'p_nothing_t': 'Nada para instalar',
    'p_nothing': 'Escolhe um ou vários ficheiros .py do programa.',
    'p_ignored': 'Ignorados: %s.',
    'p_notinst_t': 'Não instalado',
    'p_unchanged': 'O programa ficou como estava.',
    'p_installed': 'Instalados: %s.',
    'p_inst_note': 'O botão reinicia com a nova versão. Se não conseguir ligar ao Sonos, volta sozinho à anterior. Já podes voltar ao wifi de casa.',
    'p_updated_t': 'Atualizado ✓',
}
