knobeast/knobeast/pico/certs.py

# certs.py — certificados raíz con los que el mando comprueba el servidor de actualizaciones.
# ISRG Root X1 y X2 (Let's Encrypt). Caducan en 2035 y 2040.
ROOTS = (
    # ISRG Root X1
    b'0\x82\x05k0\x82\x03S\xa0\x03\x02\x01\x02\x02\x11\x00\x82\x10\xcf\xb0\xd2@\xe3YDc\xe0\xbbc\x82\x8b\x000\r\x06\t*\x86H\x86\xf7\r\x01\x01\x0b\x05\x000O1\x0b0\t\x06\x03U\x04\x06\x13\x02US1)0\'\x06\x03U\x04\n\x13 Internet Security Research Group1\x150\x13\x06\x03U\x04\x03\x13\x0cISRG Root X10\x1e\x17\r150604110438Z\x17\r350604110438Z0O1\x0b0\t\x06\x03U\x04\x06\x13\x02US1)0\'\x06\x03U\x04\n\x13 Internet Security Research Group1\x150\x13\x06\x03U\x04\x03\x13\x0cISRG Root X10\x82\x02"0\r\x06\t*\x86H\x86\xf7\r\x01\x01\x01\x05\x00\x03\x82\x02\x0f\x000\x82\x02\n\x02\x82\x02\x01\x00\xad\xe8$s\xf4\x147\xf3\x9b\x9e+W(\x1c\x87\xbe\xdc\xb7\xdf8\x90\x8cn<\xe6W\xa0x\xf7u\xc2\xa2\xfe\xf5jn\xf6\x00O(\xdb\xdeh\x86lD\x93\xb6\xb1c\xfd\x14\x12k\xbf\x1f\xd2\xea1\x9b!~\xd13<\xbaH\xf5\xddy\xdf\xb3\xb8\xff\x12\xf1!\x9aK\xc1\x8a\x86qiJffl\x8f~<p\xbf\xad)"\x06\xf3\xe4\xc0\xe6\x80\xae\xe2K\x8f\xb7\x99~\x94\x03\x9f\xd3G\x97|\x99H#S\xe88\xaeO\no\x83.\xd1IW\x8c\x80t\xb6\xda/\xd08\x8d{\x03p!\x1bu\xf20<\xfa\x8f\xae\xdd\xdac\xab\xeb\x16O\xc2\x8e\x11K~\xcf\x0b\xe8\xff\xb5w.\xf4\xb2{J\xe0L\x12%\x0cp\x8d\x03)\xa0\xe1S$\xec\x13\xd9\xee\x19\xbf\x10\xb3J\x8c?\x89\xa3aQ\xde\xac\x87\x07\x94\xf4cq\xec.\xe2o[\x98\x81\xe1\x89\\4ylv\xef;\x90by\xe6\xdb\xa4\x9a/&\xc5\xd0\x10\xe1\x0e\xde\xd9\x10\x8e\x16\xfb\xb7\xf7\xa8\xf7\xc7\xe5\x02\x07\x98\x8f6\x08\x95\xe7\xe27\x96\r6u\x9e\xfb\x0er\xb1\x1d\x9b\xbc\x03\xf9I\x05\xd8\x81\xdd\x05\xb4*\xd6A\xe9\xac\x01v\x95\n\x0f\xd8\xdf\xd5\xbd\x12\x1f5/(\x17l\xd2\x98\xc1\xa8\tdwnG7\xba\xce\xacY^h\x9d\x7fr\xd6\x89\xc5\x06A)>Y>\xdd&\xf5$\xc9\x11\xa7Z\xa3L@\x1fF\xa1\x99\xb5\xa7:Qn\x86;\x9e}r\xa7\x12\x05xY\xed>Qx\x15\x0b\x03\x8f\x8d\xd0/\x05\xb2>{J\x1cKs\x05\x12\xfc\xc6\xea\xe0P\x13|C\x93t\xb3\xcat\xe7\x8e\x1f\x01\x08\xd00\xd4[q6\xb4\x07\xba\xc100\\H\xb7\x82;\x98\xa6}`\x8a\xa2\xa3)\x82\xcc\xba\xbd\x83\x04\x1b\xa2\x83\x03A\xa1\xd6\x05\xf1\x1b\xc2\xb6\xf0\xa8|\x86;F\xa8H*\x88\xdcv\x9av\xbf\x1fj\xa5=\x19\x8f\xeb8\xf3d\xde\xc8+\r\n(\xff\xf7\xdb\xe2\x15B\xd4"\xd0\']\xe1y\xfe\x18\xe7p\x88\xadN\xe6\xd9\x8b:\xc6\xdd\'Qn\xff\xbcd\xf53CO\x02\x03\x01\x00\x01\xa3B0@0\x0e\x06\x03U\x1d\x0f\x01\x01\xff\x04\x04\x03\x02\x01\x060\x0f\x06\x03U\x1d\x13\x01\x01\xff\x04\x050\x03\x01\x01\xff0\x1d\x06\x03U\x1d\x0e\x04\x16\x04\x14y\xb4Y\xe6{\xb6\xe5\xe4\x01s\x80\x08\x88\xc8\x1aX\xf6\xe9\x9bn0\r\x06\t*\x86H\x86\xf7\r\x01\x01\x0b\x05\x00\x03\x82\x02\x01\x00U\x1fX\xa9\xbc\xb2\xa8P\xd0\x0c\xb1\xd8\x1ai \')\x08\xacau\\\x8an\xf8\x82\xe5i/\xd5\xf6VK\xb9\xb8s\x10Y\xd3!\x97~\xe7Lq\xfb\xb2\xd2`\xad9\xa8\x0b\xea\x17!V\x85\xf1P\x0eY\xeb\xce\xe0Y\xe9\xba\xc9\x15\xef\x86\x9d\x8f\x84\x80\xf6\xe4\xe9\x91\x90\xdc\x17\x9bb\x1bE\xf0f\x95\xd2|o\xc2\xea;\xef\x1f\xcf\xcb\xd6\xae\'\xf1\xa9\xb0\xc8\xae\xfd}~\x9a\xfa"\x04\xeb\xff\xd9\x7f\xea\x91+"\xb1\x17\x0e\x8f\xf2\x8a4[X\xd8\xfc\x01\xc9T\xb9\xb8&\xcc\x8a\x883\x89L-\x84<\x82\xdf\xee\x96W\x05\xba,\xbb\xf7\xc4\xb7\xc7N;\x82\xbe1\xc8"ss\x92\xd1\xc2\x80\xa499\x103#\x82L<\x9f\x86\xb2U\x98\x1d\xbe)\x86\x8c"\x9b\x9e\xe2k;W:\x82pM\xdc\t\xc7\x89\xcb\n\x07Ml\xe8]\x8e\xc9\xef\xce\xab\xc7\xbb\xb5+NE\xd6J\xd0&\xcc\xe5r\xca\x08j\xa5\x95\xe3\x15\xa1\xf7\xa4\xed\xc9,_\xa5\xfb\xff\xac(\x02.\xbe\xd7{\xbb\xe3q{\x90\x16\xd3\x07^FS|7\x07B\x8c\xd3\xc4\x96\x9c\xd5\x99\xb5*\xe0\x95\x1a\x80H\xaeL9\x07\xce\xccG\xa4R\x95+\xba\xb8\xfb\xad\xd23S}\xe5\x1dMm\xd5\xa1\xb1\xc7Bo\xe6@\'5\\\xa3(\xb7\x07\x8d\xe7\x8d3\x90\xe7#\x9f\xfbP\x9cylF\xd5\xb4\x15\xb3\x96n~\x9b\x0c\x96:\xb8R-?\xd6[\xe1\xfb\x08\xc2\x84\xfe$\xa8\xa3\x89\xda\xacj\xe1\x18*\xb1\xa8Ca[\xd3\x1f\xdc;\x8dv\xf2-\xe8\x8du\xdf\x173l=S\xfb{\xcbA_\xff\xdc\xa2\xd0a8\xe1\x96\xb8\xac]\x8b7\xd7u\xd53\xc0\x99\x11\xae\x9dA\xc1ru\x84\xbe\x02AB_g$H\x94\xd1\x9b\'\xbe\x07?\xb9\xb8O\x81tQ\xe1z\xb7\xed\x9d#\xe2\xbe\xe0\xd5(\x04\x13<1\x03\x9e\xddzl\x8f\xc6\x07\x18\xc6\x7f\xdeG\x8e?(\x9e\x04\x06\xcf\xa5T4w\xbd\xec\x89\x9b\xe9\x17C\xdf[\xdb_\xfe\x8e\x1eW\xa2\xcd@\x9d~b"\xda\xde\x18\'',
    # ISRG Root X2
    b'0\x82\x02\x1b0\x82\x01\xa1\xa0\x03\x02\x01\x02\x02\x10A\xd2\x9d\xd1r\xea\xee\xa7\x80\xc1,l\xe9/\x87R0\n\x06\x08*\x86H\xce=\x04\x03\x030O1\x0b0\t\x06\x03U\x04\x06\x13\x02US1)0\'\x06\x03U\x04\n\x13 Internet Security Research Group1\x150\x13\x06\x03U\x04\x03\x13\x0cISRG Root X20\x1e\x17\r200904000000Z\x17\r400917160000Z0O1\x0b0\t\x06\x03U\x04\x06\x13\x02US1)0\'\x06\x03U\x04\n\x13 Internet Security Research Group1\x150\x13\x06\x03U\x04\x03\x13\x0cISRG Root X20v0\x10\x06\x07*\x86H\xce=\x02\x01\x06\x05+\x81\x04\x00"\x03b\x00\x04\xcd\x9b\xd5\x9f\x80\x83\n\xec\tJ\xf3\x16J>\\\xcfw\xac\xdeg\x05\r\x1d\x07\xb6\xdc\x16\xfbZ\x8b\x14\xdb\xe2q`\xc4\xbaE\x95\x11\x89\x8e\xea\x06\xdf\xf7*\x16\x1c\xa4\xb9\xc5\xc52\xe0\x03\xe0\x1e\x82\x188\x8b\xd7E\xd8\njn\xe6\x00w\xfb\x02Q}"\xd8\nn\x9a[w\xdf\xf0\xfaA\xec9\xdcu\xcah\x07\x0c\x1f\xea\xa3B0@0\x0e\x06\x03U\x1d\x0f\x01\x01\xff\x04\x04\x03\x02\x01\x060\x0f\x06\x03U\x1d\x13\x01\x01\xff\x04\x050\x03\x01\x01\xff0\x1d\x06\x03U\x1d\x0e\x04\x16\x04\x14|B\x96\xae\xdeKH;\xfa\x92\xf8\x9e\x8c\xcfm\x8b\xa9r7\x950\n\x06\x08*\x86H\xce=\x04\x03\x03\x03h\x000e\x020{yNFP\x84\xc2D\x87F\x1bEp\xffX\x99\xde\xf4\xfd\xa4\xd2U\xa6 -t\xd64\xbcA\xa3P_\x01\'V\xb4\xbe\'u\x06\xaf\x12.u\x98\x8d\xfc\x021\x00\x8b\xf5wl\xd4\xc8e\xaa\xe0\x0b,\xee\x14\x9d\'7\xa4\xf9S\xa5Q\xe4)\x83\xd7\xf8\x901[B\x9f\n\xf5\xfe\xae\x00h\xe7\x8cI\x0f\xb6o[[\x15\xf2\xe7',
)
