knobeast/knobeast/(commit log)

2026-10-17 knobeast 2.0.1 — first public release
    Physical volume knob for Sonos: MicroPython firmware for the Raspberry Pi
    Pico 2 W (community edition, updated by hand), printable case (OpenSCAD +
    STL), wiring and dimension drawings, build guide (EN/ES).
    [knobeast_1_carcasa.stl, knobeast_2_tapa_inferior.stl, knobeast_3_pomo.stl, knobeast_4_soporte_pared.stl, knobeast_caja.scad, logo_knobeast.scad]
2026-10-18 2.0.6: easier speaker picking, battery auto-detect, Wi-Fi name fix, new display mount
    [knobeast_1_carcasa.stl, knobeast_caja.scad]
